Gasparrocha/Linefollower_bluetooth/(list of files, drawings)

Other design files:
LineFollower/LineFlower.fzz
